Orekaria/motorhome_step/(list of files, drawings)

Other design files:
proteus/motorhome_step.pdsprj
proteus/Project Backups/proteus [20220109, 02-21-56].pdsprj
proteus/Project Backups/proteus [Proteus 8.9].pdsprj
