Orekaria/motorhome_step/(commit log)

2022-01-20 Legacy code with interrupts
    [proteus [20220109, 02-21-56].pdsprj, proteus [Proteus 8.9].pdsprj, proteus.pdsprj]
2022-01-20 Minimize power comsumption
    - added LowPower library
    - use of interruptions
    - power down when actions and timers are finished
2022-01-25 Working prototype 2.0
2022-02-10 Reduce CPU speed to 8Mhz to safetly run with 3.3V
2022-02-10 Add proteus project
    [motorhome_step.pdsprj]
2022-02-11 Update I2Cdev
2022-02-11 Detect if the motion sensor is available
2022-02-12 Deactivate gyros and temp sensor
2022-02-12 Move the sleep mode to PowerConsumption
2022-02-13 Deactivate gyro calibration - better log
2022-02-13 Always high when executing the sketch. Keep low when waiting for interrupts
2022-02-14 Easy to maintain how the relay is switched
2022-02-19 Buzzer. It is consuming 13mA when active.
    [main.cpp]
2022-02-19 Initialize pins in low power mode
2022-02-19 Change to INPUT/OUTPUT pin mode, because INPUT-PULLUP increases current consumption by 50-80nA per pin
2022-02-19 Update Proteus project
    [motorhome_step.pdsprj]
2022-02-21 Use a passive buzzer - because I broke the active one
    [main.cpp]
2022-02-24 Added schematic image
2022-02-24 Added schematic image (02)
2022-02-24 Add non-calibration mode
2022-03-17 Remove auto-slide-in. When the step is extended, keep it extended until motion is detected - add a counter to filter motions which source is inside the vehicle
2022-03-17 Add the buzzer library
    [main.cpp]
2022-03-17 Filter motion detected inside the vehicle
2022-03-17 Change to an Active buzzer - the sound is louder
    [main.cpp]
2022-03-18 Filter motion detected inside the vehicle (02) - remove beep when 1/2 motion is detected
2022-03-18 Switch buttons
